je1rav/QP-7C/images/QP-7C_TRX2_diagram.pdf

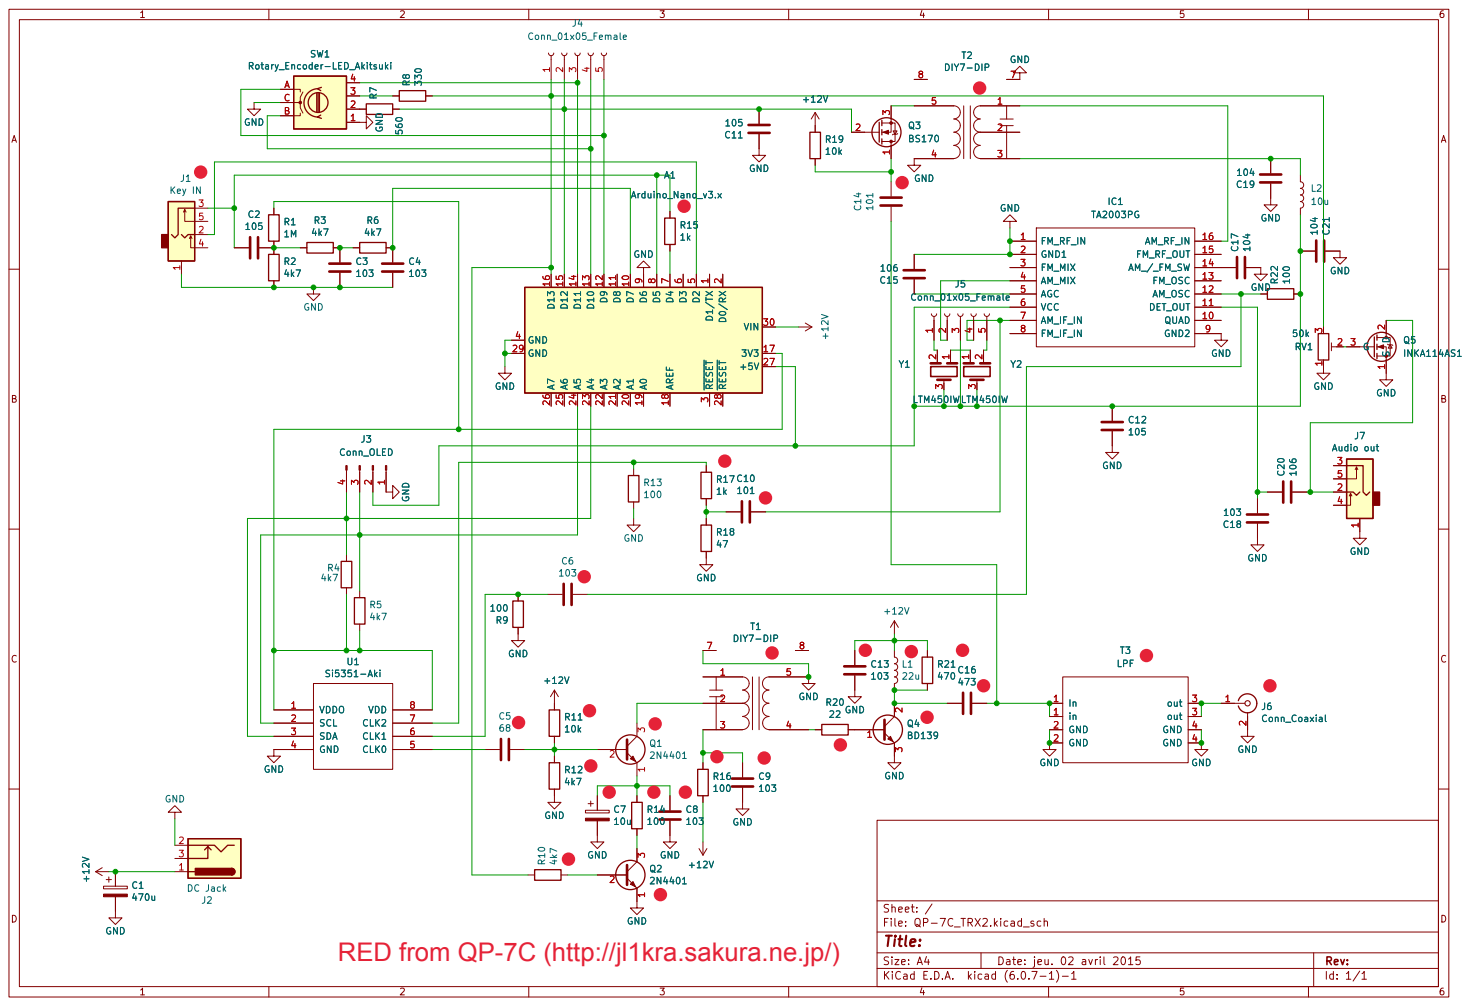
[picture p31: page 1]

J4 Conn_01x05_Female R6

2 A1 20 A2 21 A3 22 A4 23 A5 24 A6 25 A7 26 +5V 27 ~{RESET} 28 GND 29 ~{RESET} 3 VIN 30 GND 4 D2

File: QP-7C_TRX2.kicad_sch Sheet: / GND

RED from QP-7C (http://jl1kra.sakura.ne.jp/)
