je1rav/QP-7C/images/QP-7C_TRX-PCB_LPF.pdf

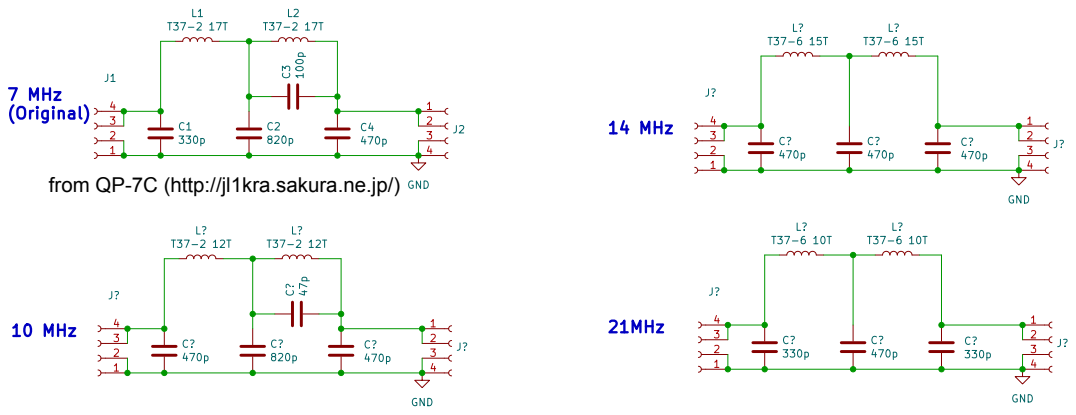
[picture p32: page 1]

File: LPF-QP-temp.kicad_sch Sheet: /
Id: 1/1 Title:
