je1rav/QP-7C/images/QP-7C_TRX-PCB_LPF2.pdf

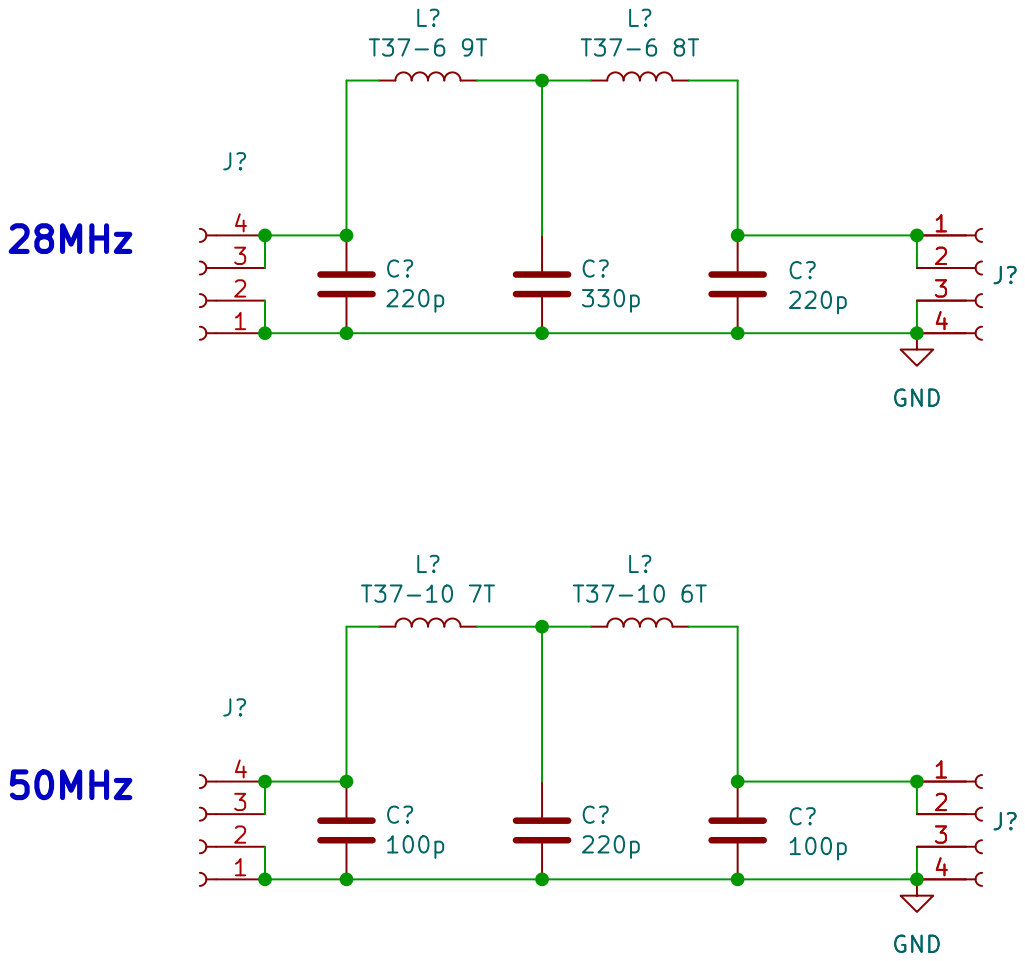
[picture p33: page 1]
