je1rav/QP-7C/images/QP-7C_TRX-PCB_digagram.pdf

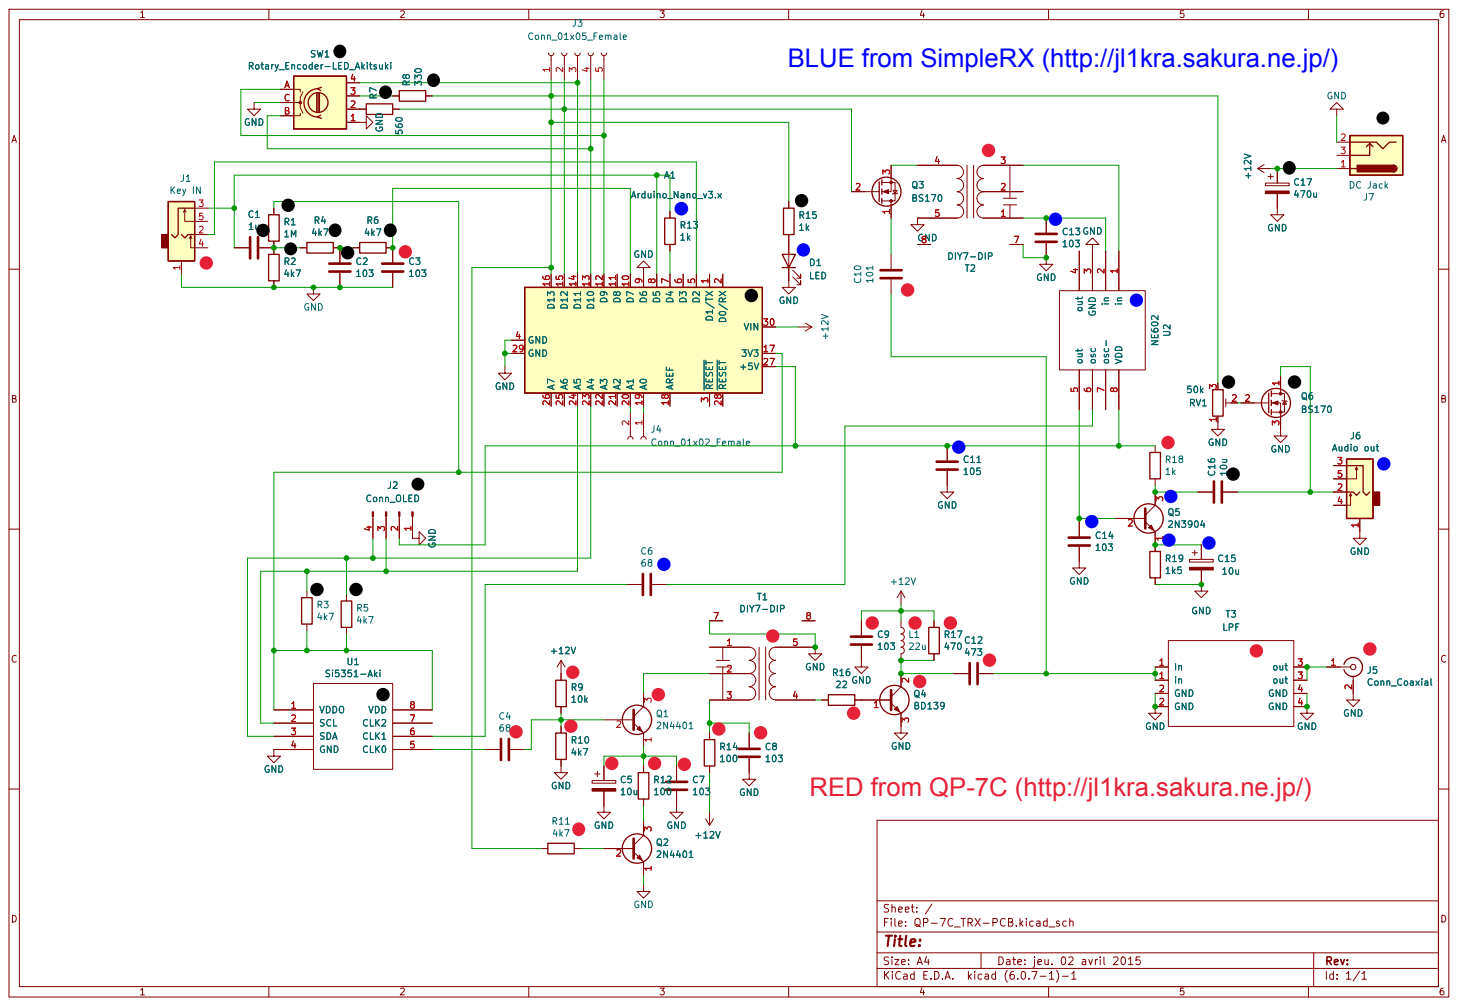
[picture p34: page 1]

BLUE from SimpleRX (http://jl1kra.sakura.ne.jp/)
